kongr45gpen/puzzle-pcb/sciencefestivalpcb/sciencefestivalpcb.kicad_pcb

## KiCad design sciencefestivalpcb/sciencefestivalpcb.kicad_pcb (2023-10-26)

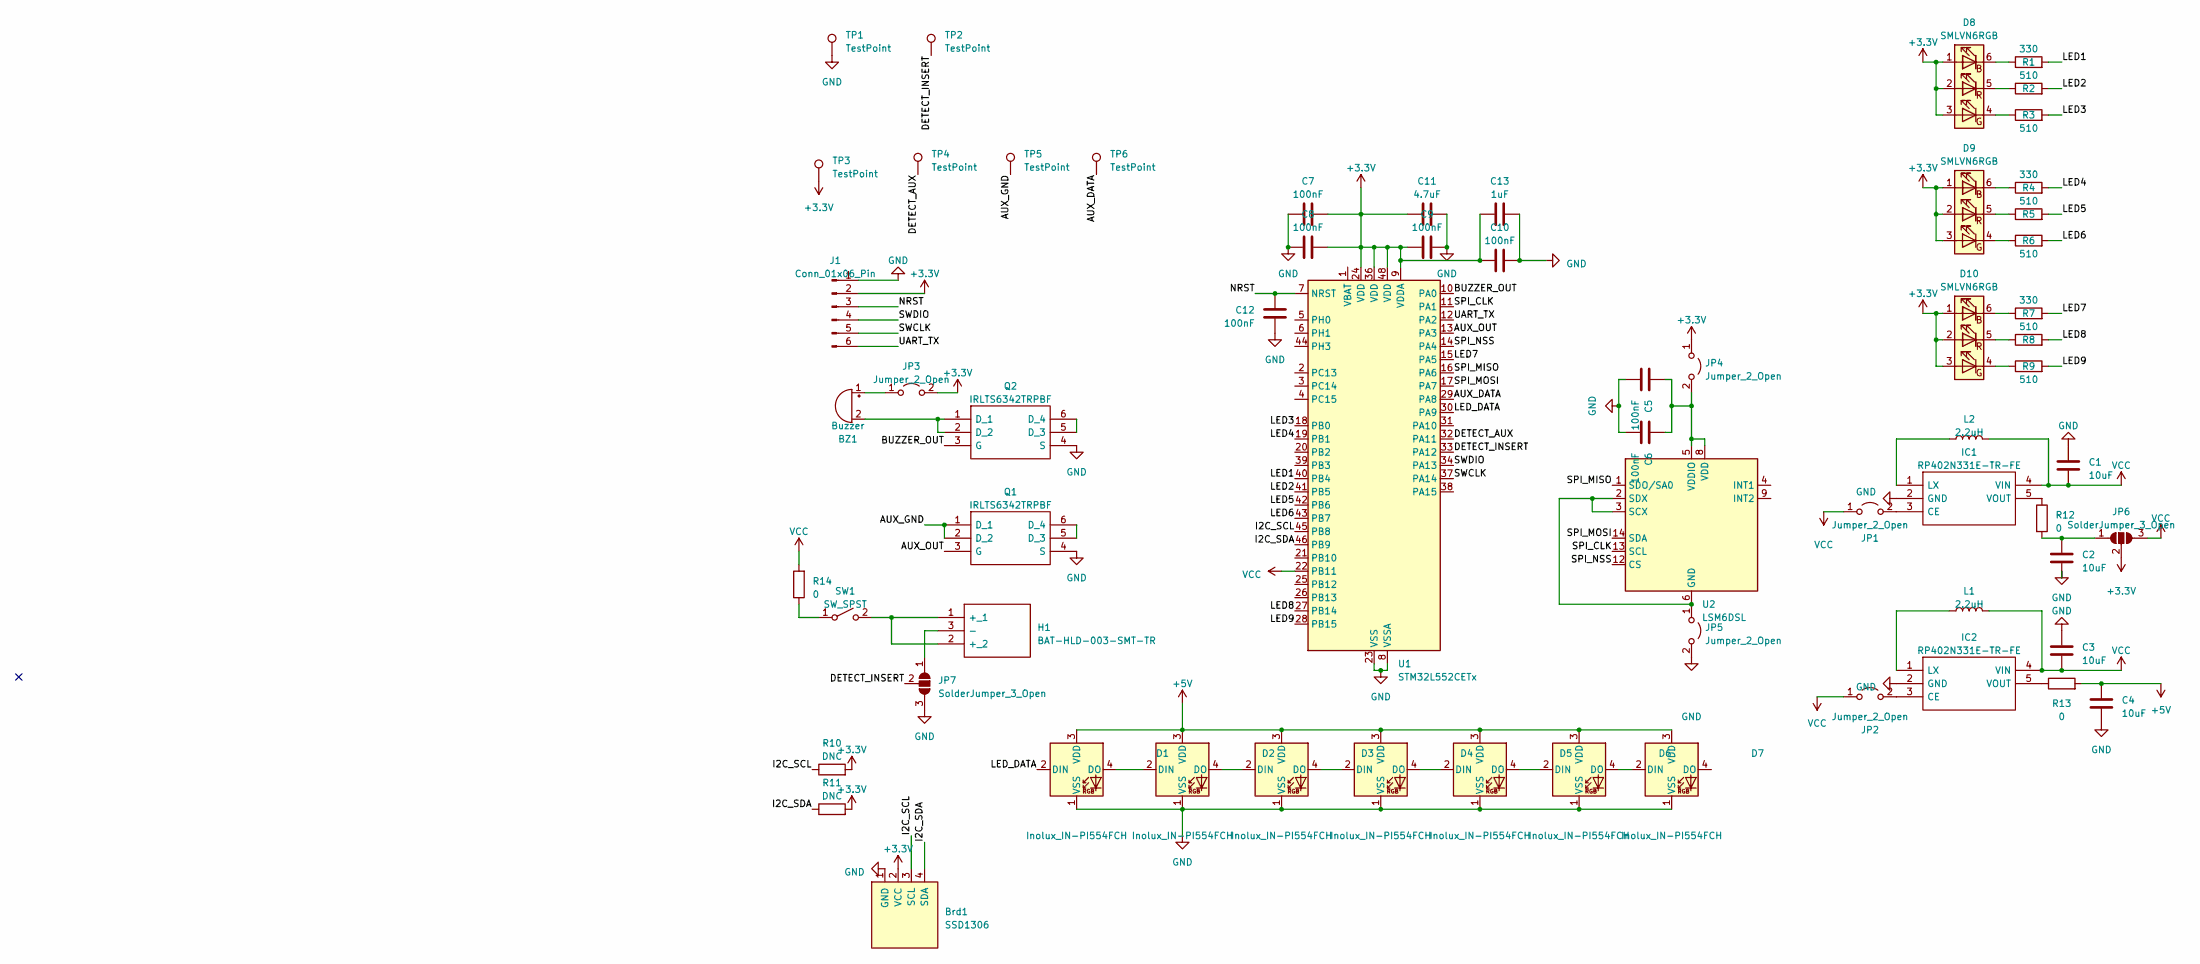
[picture p1: schematic sciencefestivalpcb.kicad_sch]

Parts:
BZ1: Buzzer; Buzzer_12x9.5RM7.6; MPN CSQG703BP
Brd1: SSD1306; 128x64OLED
C1, C2, C3, C4: 10uF; C_0603_1608Metric_Pad1.08x0.95mm_HandSolder; MPN 06033D106KAT2A
C5, C6, C7, C8, C9, C10, C12: 100nF; C_0603_1608Metric_Pad1.08x0.95mm_HandSolder; MPN GRJ188R72A104KE11D
C11: 4.7uF; C_0603_1608Metric_Pad1.08x0.95mm_HandSolder; MPN GRM188R6YA475KE15D
C13: 1uF; C_0603_1608Metric_Pad1.08x0.95mm_HandSolder; MPN 06033W105KAT2A
D1, D2, D3, D4, D5, D6, D7: Inolux_IN-PI554FCH; LED_Inolux_IN-PI554FCH_PLCC4_5.0x5.0mm_P3.2mm; MPN IN-PI554FCH
D8, D9, D10: SMLVN6RGB; LED_ROHM_SMLVN6; MPN SMLVN6RGB1U1
H1: BAT-HLD-003-SMT-TR; BATHLD003SMTTR; Manufacturer_Part_Number BAT-HLD-003-SMT-TR
IC1, IC2: RP402N331E-TR-FE; SOT95P280X130-5N; Mouser Part Number 848-RP402N331ETRFE
J1: Conn_01x06_Pin; Molex_PicoBlade_53261-0671_1x06-1MP_P1.25mm_Horizontal; MPN 53261-0671
JP1, JP2, JP3, JP4, JP5: Jumper_2_Open; SolderJumper-2_P1.3mm_Open_TrianglePad1.0x1.5mm
JP6, JP7: SolderJumper_3_Open; SolderJumper-3_P1.3mm_Open_RoundedPad1.0x1.5mm
L1, L2: 2.2uH; L_0805_2012Metric_Pad1.05x1.20mm_HandSolder; MPN IHHP0805ZHER2R2M01
Q1, Q2: IRLTS6342TRPBF; SOT95P280X145-6N; Mouser Part Number 942-IRLTS6342TRPBF
R1, R4, R7: 330; R_0603_1608Metric_Pad0.98x0.95mm_HandSolder; MPN ERJ-UP3J331V
R2, R3, R5, R6, R8, R9: 510; R_0603_1608Metric_Pad0.98x0.95mm_HandSolder; MPN ERJ-UP3F5100V
R10, R11: DNC; R_0603_1608Metric_Pad0.98x0.95mm_HandSolder
R12, R13, R14: 0; R_0603_1608Metric_Pad0.98x0.95mm_HandSolder; MPN ERJ-3GEY0R00V
SW1: SW_SPST; SW_DIP_SPSTx01_Slide_Omron_A6S-110x_W8.9mm_P2.54mm; MPN A6S-1102-PH
TP1, TP2, TP3, TP4, TP5, TP6: TestPoint; TestPoint_Pad_D4.0mm
U1: STM32L552CETx; LQFP-48_7x7mm_P0.5mm; MPN STM32L552CET6
U2: LSM6DSL; LGA-14_3x2.5mm_P0.5mm_LayoutBorder3x4y; MPN LSM6DSLTR

Connections:
+3.3V: Brd1.2 (VCC), C7.2, C8.2, C9.1, C10.1, C11.1, C13.1, D8.1 (BA), D8.2 (RA), D8.3 (GA), D9.1 (BA), D9.2 (RA), D9.3 (GA), D10.1 (BA), D10.2 (RA), D10.3 (GA), J1.2, JP3.2 (B), JP4.1 (A), JP6.2 (C), R10.2, R11.2, TP3.1, U1.9 (VDDA), U1.24 (VDD), U1.36 (VDD), U1.48 (VDD)
+5V: C4.1, D1.3 (VDD), D2.3 (VDD), D3.3 (VDD), D4.3 (VDD), D5.3 (VDD), D6.3 (VDD), D7.3 (VDD), R13.2
/AUX_DATA: TP6.1, U1.29 (PA8)
/AUX_GND: Q1.1 (D_1), Q1.2 (D_2), TP5.1
/AUX_OUT: Q1.3 (G), U1.13 (PA3)
/BUZZER_OUT: Q2.3 (G), U1.10 (PA0)
/DETECT_AUX: TP4.1, U1.32 (PA11)
/DETECT_INSERT: JP7.2 (C), TP2.1, U1.33 (PA12)
/I2C_SCL: Brd1.3 (SCL), R10.1, U1.45 (PB8)
/I2C_SDA: Brd1.4 (SDA), R11.1, U1.46 (PB9)
/LED1: R1.2, U1.40 (PB4)
/LED2: R2.2, U1.41 (PB5)
/LED3: R3.2, U1.18 (PB0)
/LED4: R4.2, U1.19 (PB1)
/LED5: R5.2, U1.42 (PB6)
/LED6: R6.2, U1.43 (PB7)
/LED7: R7.2, U1.15 (PA5)
/LED8: R8.2, U1.27 (PB14)
/LED9: R9.2, U1.28 (PB15)
/LED_DATA: D1.2 (DIN), U1.30 (PA9)
/NRST: C12.2, J1.3, U1.7 (NRST)
/SPI_CLK: U1.11 (PA1), U2.13 (SCL)
/SPI_MISO: U1.16 (PA6), U2.1 (SDO/SA0)
/SPI_MOSI: U1.17 (PA7), U2.14 (SDA)
/SPI_NSS: U1.14 (PA4), U2.12 (CS)
/SWCLK: J1.5, U1.37 (PA14)
/SWDIO: J1.4, U1.34 (PA13)
/UART_TX: J1.6, U1.12 (PA2)
GND: Brd1.1 (GND), C1.1, C2.2, C3.1, C4.2, C5.2, C6.2, C7.1, C8.1, C9.2, C10.2, C11.2, C12.1, C13.2, D1.1 (VSS), D2.1 (VSS), D3.1 (VSS), D4.1 (VSS), D5.1 (VSS), D6.1 (VSS), D7.1 (VSS), IC1.2 (GND), IC2.2 (GND), J1.1, JP5.2 (B), JP7.3 (B), Q1.4 (S), Q2.4 (S), TP1.1, U1.8 (VSSA), U1.23 (VSS), U1.35 (VSS), U1.47 (VSS)
unnamed: BZ1.2 (+), Q2.1 (D_1), Q2.2 (D_2)
unnamed: BZ1.1 (-), JP3.1 (A)
unnamed: D1.4 (DO), D2.2 (DIN)
unnamed: D2.4 (DO), D3.2 (DIN)
unnamed: D3.4 (DO), D4.2 (DIN)
unnamed: D4.4 (DO), D5.2 (DIN)
unnamed: D5.4 (DO), D6.2 (DIN)
unnamed: D6.4 (DO), D7.2 (DIN)
unnamed: D8.6 (BK), R1.1
unnamed: D8.4 (GK), R3.1
unnamed: D8.5 (RK), R2.1
unnamed: D9.6 (BK), R4.1
unnamed: D9.4 (GK), R6.1
unnamed: D9.5 (RK), R5.1
unnamed: D10.6 (BK), R7.1
unnamed: D10.4 (GK), R9.1
unnamed: D10.5 (RK), R8.1
unnamed: H1.1 (+_1), H1.2 (+_2), SW1.2 (B)
unnamed: H1.3 (-), JP7.1 (A)
unnamed: IC1.3 (CE), JP1.2 (B)
unnamed: IC1.1 (LX), L2.1
unnamed: IC1.5 (VOUT), R12.1
unnamed: IC2.3 (CE), JP2.2 (B)
unnamed: IC2.1 (LX), L1.1
unnamed: IC2.5 (VOUT), R13.1
unnamed: C5.1, C6.1, JP4.2 (B), U2.5 (VDDIO), U2.8 (VDD)
unnamed: JP5.1 (A), U2.2 (SDX), U2.3 (SCX), U2.6 (GND), U2.7 (GND)
unnamed: C2.1, JP6.1 (A), R12.2
unnamed: Q1.5 (D_3), Q1.6 (D_4)
unnamed: Q2.5 (D_3), Q2.6 (D_4)
unnamed: R14.1, SW1.1 (A)
VCC: C1.2, C3.2, IC1.4 (VIN), IC2.4 (VIN), JP1.1 (A), JP2.1 (A), JP6.3 (B), L1.2, L2.2, R14.2, U1.22 (PB11)

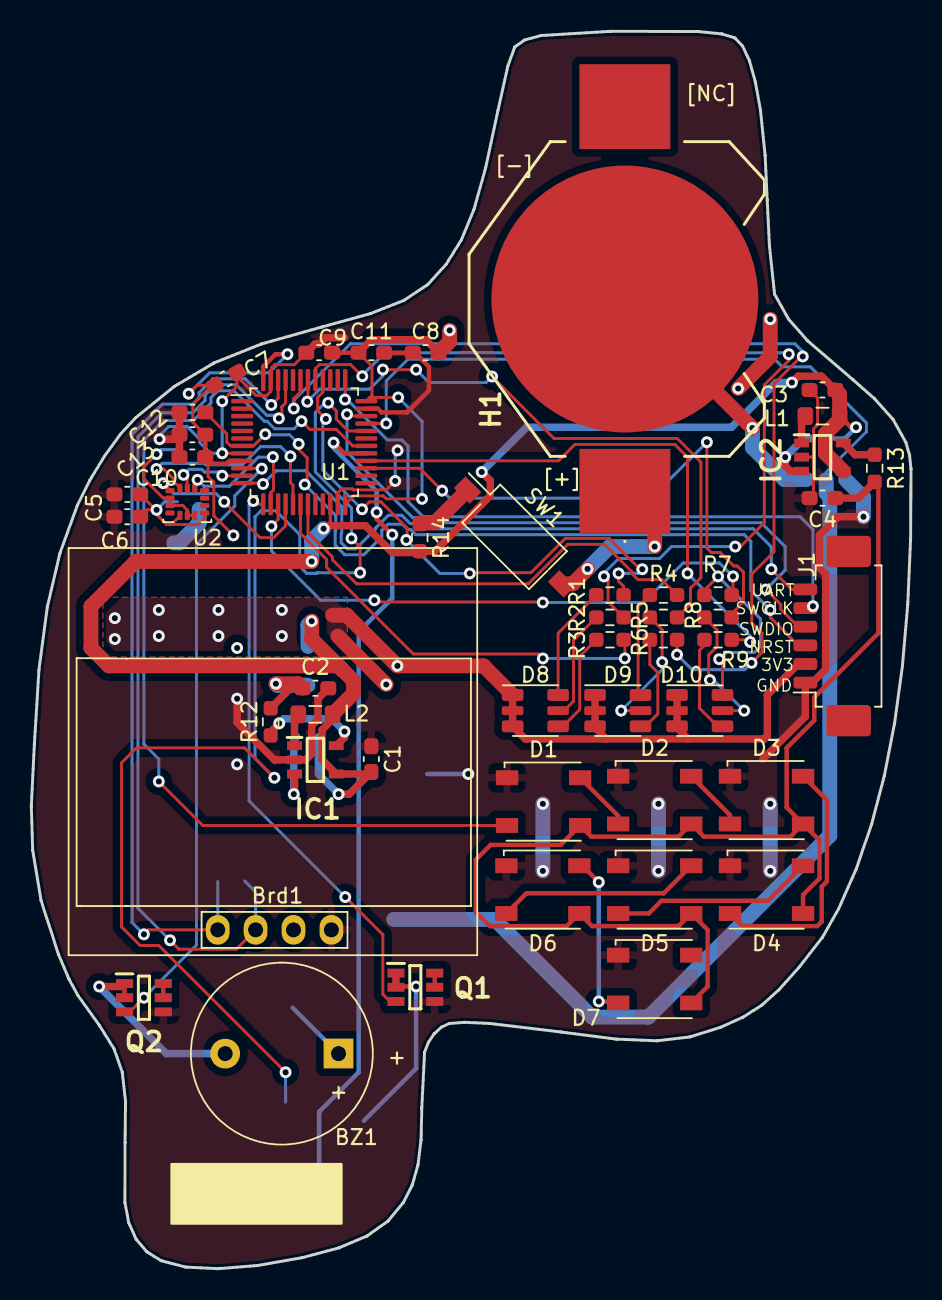
[picture p2: board sciencefestivalpcb.kicad_pcb from above]

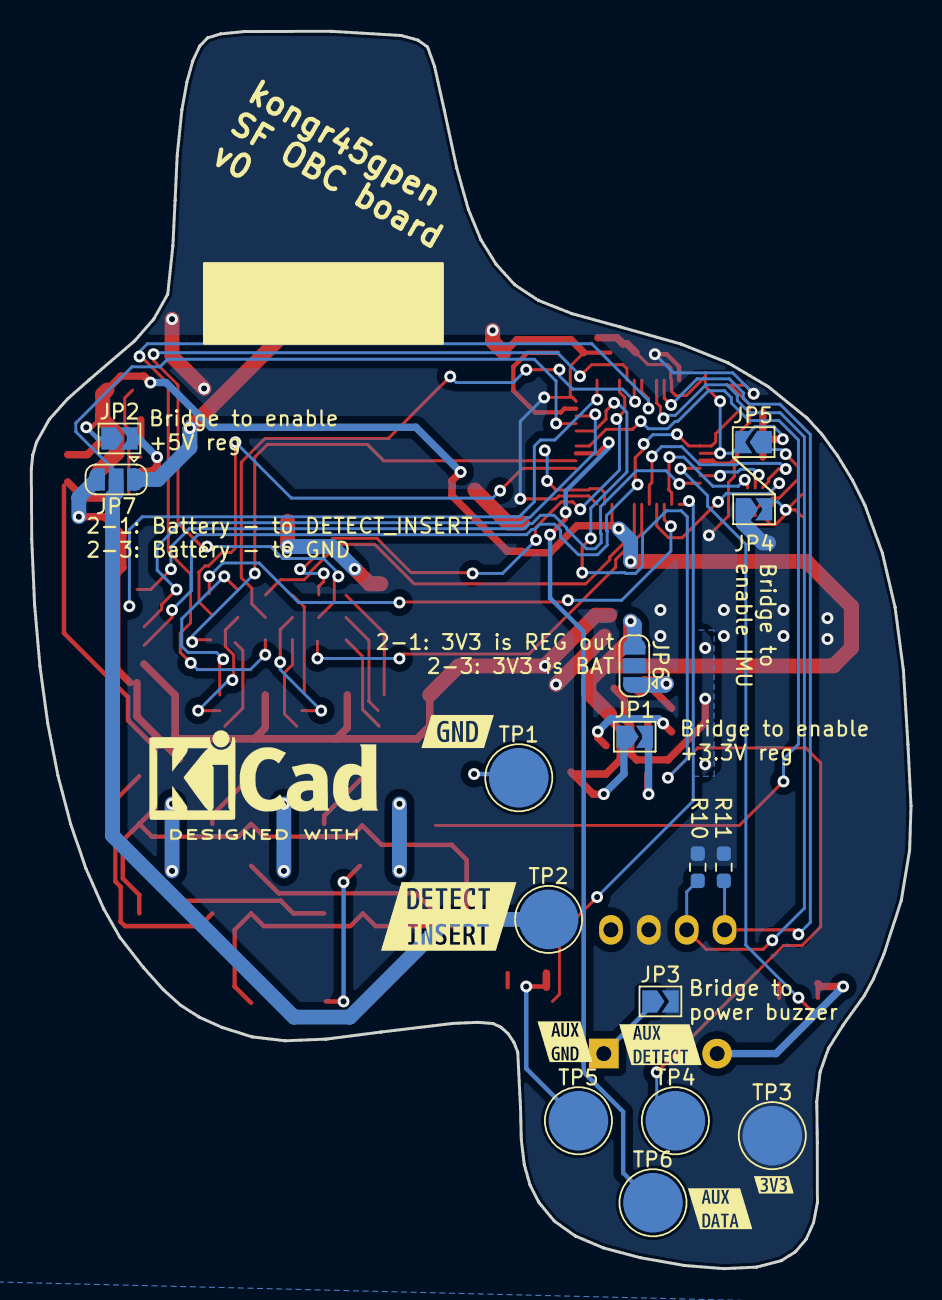
[picture p3: board sciencefestivalpcb.kicad_pcb from below]

Board: 2 copper layers, 59.0 x 83.0 mm, 69 parts (21 on the bottom side), 61 nets.

Other parts of the board:
kibuzzard-65245FE4: G***; kibuzzard-65245FE4
kibuzzard-652460C9: G***; kibuzzard-652460C9
kibuzzard-652460E7: G***; kibuzzard-652460E7
kibuzzard-652460F2: G***; kibuzzard-652460F2
kibuzzard-652460F9: G***; kibuzzard-652460F9
kibuzzard-65246046: G***; kibuzzard-65246046
