kongr45gpen/puzzle-pcb/firmware/Core/Src/main.c

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
/* Includes ------------------------------------------------------------------*/
#include "main.h"

/* USER CODE BEGIN Includes */
#include "../../Drivers/SSD1306/ssd1306.h"
#include "../../Drivers/SSD1306/ssd1306_tests.h"
#include "images.h"
/* USER CODE END Includes */

/* USER CODE BEGIN PTD */
#include "math.h"
#include "stdbool.h"
/* USER CODE END PTD */

/* USER CODE BEGIN PD */
const int startSoundDelay = 7;
const int stopSoundDelay = 15;
const int sleepDelay = 100;
/* USER CODE END PD */

I2C_HandleTypeDef hi2c1;

TIM_HandleTypeDef htim2;
TIM_HandleTypeDef htim3;
TIM_HandleTypeDef htim4;
TIM_HandleTypeDef htim5;
TIM_HandleTypeDef htim15;

UART_HandleTypeDef huart2;

void SystemClock_Config(void);
static void MX_GPIO_Init(void);
static void MX_I2C1_Init(void);
static void MX_USART2_UART_Init(void);
static void MX_ICACHE_Init(void);
static void MX_TIM2_Init(void);
static void MX_TIM3_Init(void);
static void MX_TIM4_Init(void);
static void MX_TIM5_Init(void);
static void MX_TIM15_Init(void);
/**
  * @brief  The application entry point.
  * @retval int
  */
int main(void)
{
  /* MCU Configuration--------------------------------------------------------*/

  /* Reset of all peripherals, Initializes the Flash interface and the Systick. */
  HAL_Init();

  /* Configure the system clock */
  SystemClock_Config();

  /* Initialize all configured peripherals */
  MX_GPIO_Init();
  MX_I2C1_Init();
  MX_USART2_UART_Init();
  MX_ICACHE_Init();
  MX_TIM2_Init();
  MX_TIM3_Init();
  MX_TIM4_Init();
  MX_TIM5_Init();
  MX_TIM15_Init();
  /* USER CODE BEGIN 2 */
  int loops = 0;
  uint32_t lastTime = 0;
  enum Status {
      ERREUR,
      ROCKET
  };
    enum Status status = ERREUR;

    enum PCBStatus {
        PLUGGED,
        UNPLUGGED
    };
    enum PCBStatus oldStatus = PLUGGED;
    enum PCBStatus pcbStatus = UNPLUGGED;

    bool screenConnected = false;
    bool mustUpdateScreen = false;
    bool debouncedStart = true;
  /* USER CODE END 2 */

  /* Infinite loop */
  /* USER CODE BEGIN WHILE */
  while (1)
  {
    /* USER CODE END WHILE */

    /* USER CODE BEGIN 3 */

    HAL_TIM_Base_Start(&htim2);
    HAL_TIM_Base_Start(&htim3);
    HAL_TIM_Base_Start(&htim4);
    HAL_TIM_Base_Start(&htim5);
    HAL_TIM_Base_Start(&htim15);

    HAL_TIM_PWM_Start(&htim2, TIM_CHANNEL_1);
    HAL_TIM_PWM_Start(&htim3, TIM_CHANNEL_1);
    HAL_TIM_PWM_Start(&htim3, TIM_CHANNEL_2);
    HAL_TIM_PWM_Start(&htim3, TIM_CHANNEL_3);
    HAL_TIM_PWM_Start(&htim3, TIM_CHANNEL_4);
    HAL_TIM_PWM_Start(&htim4, TIM_CHANNEL_1);
    HAL_TIM_PWM_Start(&htim4, TIM_CHANNEL_2);
    HAL_TIM_PWM_Start(&htim15, TIM_CHANNEL_1);
    HAL_TIM_PWM_Start(&htim15, TIM_CHANNEL_2);

    if (!HAL_GPIO_ReadPin(DETECT_INSERT_GPIO_Port, DETECT_INSERT_Pin)) {
        pcbStatus = PLUGGED;
    } else {
        pcbStatus = UNPLUGGED;
    }

    if (is_screen_connected()) {
        if (!screenConnected) {
            ssd1306_Init();
            ssd1306_Fill(Black);
            ssd1306_UpdateScreen();
            mustUpdateScreen = true;
        }
        screenConnected = true;
    } else {
        screenConnected = false;
    }

    if (oldStatus != pcbStatus && pcbStatus == UNPLUGGED) {
        //debounce
        HAL_Delay(100);
        if (!HAL_GPIO_ReadPin(DETECT_INSERT_GPIO_Port, DETECT_INSERT_Pin)) {
            // Plugged
            continue;
        }
    }

    // PCB status changed!
    if (oldStatus != pcbStatus) {
        oldStatus = pcbStatus;
        loops = 0;
        lastTime = HAL_GetTick();

        // Turn off all leds
        leds_off();

        // Clear screen
        ssd1306_Fill(Black);
        ssd1306_UpdateScreen();

        // Stop any sound
        stop_sound();
    }

    if (pcbStatus == PLUGGED) {
        if (loops < startSoundDelay) {
            set_led(LED1B, 50);
            set_led(LED2B, 100);
            set_led(LED3B, 200);
            // DEBOUNCING
            HAL_Delay(100);
            loops++;
            debouncedStart = false;
            continue;
        } else {
            set_led(LED1B, 0);
            set_led(LED2B, 0);
            set_led(LED3B, 0);
            debouncedStart = true;
        }

        if (loops == startSoundDelay + 3) {
            start_sound(400 * powf(2, 7.0f / 12.0f));
        } else if (loops == startSoundDelay + 6) {
            stop_sound();
        } else if (loops == startSoundDelay + 9) {
            start_sound(400 * powf(2, 7.0f / 12.0f));
        } else if (loops >= startSoundDelay + 12) {
            stop_sound();
        }

        if (loops % 3 == 0) {
            static int the_led = 0;
            the_led = (the_led + 1) % 3;

            set_led(LED1G, the_led == 0 ? 1000 : 0);
            set_led(LED2G, the_led == 1 ? 1000 : 0);
            set_led(LED3G, the_led == 2 ? 1000 : 0);
        }

        int64_t pseudorandom1 = (int64_t) ((double)loops * (double)loops * 164641.73f);
        int64_t pseudorandom2 = (int64_t) ((double)loops * (double)loops * 3046751.73f);

        ssd1306_Fill(Black);
        ssd1306_DrawBitmap(35 - 10 + (pseudorandom1 % 16), pseudorandom2 % 6, rocket_58x58, 58, 58, White);

        ssd1306_UpdateScreen();

        HAL_Delay(20);
    } else { // UNPLUGGED

        float brightness = (1 - (float)loops / (float)sleepDelay);
        // gamma correction
        brightness = powf(brightness, 2.f);
        brightness *= 4095 / 3;

        if (loops >= sleepDelay || !debouncedStart) {
            stop_everything();
            // Disable systick so that it doesn't wake up the processor every ms and doesn't keep counting.
            // Hopefully will prevent some battery drain.
            HAL_NVIC_DisableIRQ(SysTick_IRQn);
            sleep();
            HAL_NVIC_EnableIRQ(SysTick_IRQn);
            continue;
        }

        if (loops == stopSoundDelay + 3) {
            start_sound(400);
        } else if (loops == stopSoundDelay + 12) {
            stop_sound();
        } else if (loops == stopSoundDelay + 20) {
            start_sound(400 * powf(2, 3.0f / 12.0f));
        } else if (loops == stopSoundDelay + 30) {
            start_sound(400 * powf(2, -3.0f / 12.0f));
        } else if (loops >= stopSoundDelay + 40) {
            stop_sound();
        }

        if (loops <= 1 || mustUpdateScreen) {
            ssd1306_SetCursor(30, 46);
            ssd1306_WriteString("ERROR", Font_11x18, White);
            ssd1306_DrawBitmap(40, 0, warning_48x48, 48, 48, White);

            ssd1306_UpdateScreen();

            mustUpdateScreen = false;
        }

        if (loops % 4 == 0) {
            set_led(LED1R, 0);
            set_led(LED2R, 0);
        } else if (loops % 2 == 0) {
            set_led(LED1R, brightness);
            set_led(LED2R, brightness);
        }
        HAL_Delay(20);
    }

//    if (HAL_GPIO_ReadPin(DETECT_INSERT_GPIO_Port, DETECT_INSERT_Pin)) {
//
//    }

//    if (HAL_GPIO_ReadPin(DETECT_INSERT_GPIO_Port, DETECT_INSERT_Pin)) {
//        HAL_GPIO_WritePin(LED3_GPIO_Port, LED3_Pin, GPIO_PIN_SET);
//        HAL_GPIO_WritePin(LED6_GPIO_Port, LED6_Pin, GPIO_PIN_SET);
//        HAL_GPIO_WritePin(LED5_GPIO_Port, LED2_Pin, GPIO_PIN_SET);
//        HAL_GPIO_WritePin(LED5_GPIO_Port, LED5_Pin, GPIO_PIN_SET);
//
//        HAL_GPIO_TogglePin(LED2_GPIO_Port, LED2_Pin);
//        HAL_Delay(30);
//        HAL_GPIO_TogglePin(LED5_GPIO_Port, LED5_Pin);
//        HAL_Delay(200);
//
//        HAL_GPIO_TogglePin(LED2_GPIO_Port, LED2_Pin);
//        HAL_GPIO_TogglePin(LED5_GPIO_Port, LED5_Pin);
//        HAL_Delay(200);
//    } else {
//        status = ERREUR;
//
//        if (loops % 3 == 0) {
//            HAL_GPIO_TogglePin(LED3_GPIO_Port, LED3_Pin);
//            HAL_GPIO_TogglePin(LED6_GPIO_Port, LED6_Pin);
//        }
//        HAL_Delay(20);
//    } //else if (loops == 5) {
//        // Turn them off
//        HAL_GPIO_WritePin(LED2_GPIO_Port, LED2_Pin, GPIO_PIN_SET);
//        HAL_GPIO_WritePin(LED5_GPIO_Port, LED5_Pin, GPIO_PIN_SET);
//
//        // Open green ones
//        HAL_GPIO_WritePin(LED3_GPIO_Port, LED3_Pin, GPIO_PIN_RESET);
//
//        status = ROCKET;
//    } else {
//        if (loops % 3 == 0) {
//            HAL_GPIO_TogglePin(LED3_GPIO_Port, LED3_Pin);
//            HAL_GPIO_TogglePin(LED6_GPIO_Port, LED6_Pin);
//        }
//        HAL_Delay(20);
//    }
//
//    if (loops % 4 == 0 && status == ERREUR) {
//        ssd1306_Init();
//    }
//
//    if (status == ERREUR && loops % 4 == 0) {
//        ssd1306_SetCursor(30, 46);
//        ssd1306_WriteString("ERROR", Font_11x18, White);
//        ssd1306_DrawBitmap(40, 0, warning_48x48, 48, 48, White);
//
//        ssd1306_UpdateScreen();
//    } else if (status == ROCKET) {
//        int64_t pseudorandom1 = (int64_t) ((double)loops * (double)loops * 164641.73f);
//        int64_t pseudorandom2 = (int64_t) ((double)loops * (double)loops * 3046751.73f);
//
//        ssd1306_Fill(Black);
//        ssd1306_DrawBitmap(35 - 10 + (pseudorandom1 % 16), pseudorandom2 % 6, rocket_58x58, 58, 58, White);
//
//        ssd1306_UpdateScreen();
//    }

    loops++;
  }
  /* USER CODE END 3 */
}

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
