kongr45gpen/puzzle-pcb/firmware/firmware.ioc

Mcu.UserName=STM32L552CETx
PA0.GPIO_Label=BUZZER_OUT
PA0.Signal=S_TIM5_CH1
PA12.GPIO_Label=DETECT_INSERT
PA12.Signal=GPXTI12
PA2.Signal=USART2_TX
PA5.Signal=S_TIM2_CH1
PB0.Signal=S_TIM3_CH3
PB1.Signal=S_TIM3_CH4
PB14.Signal=S_TIM15_CH1
PB15.Signal=S_TIM15_CH2
PB5.Signal=S_TIM3_CH2
PB6.Signal=S_TIM4_CH1
PB7.Signal=S_TIM4_CH2
PB8.Signal=I2C1_SCL
PB9.Signal=I2C1_SDA
