kongr45gpen/puzzle-pcb/firmware/Core/Inc/main.h

#define BUZZER_OUT_Pin GPIO_PIN_0
#define BUZZER_OUT_GPIO_Port GPIOA
#define DETECT_INSERT_Pin GPIO_PIN_12
#define DETECT_INSERT_GPIO_Port GPIOA
#define DETECT_INSERT_EXTI_IRQn EXTI12_IRQn
