kongr45gpen/puzzle-pcb/(commit log)

2023-10-26 Initial firmware commit
    [sciencefestivalpcb.kicad_pcb, sciencefestivalpcb.kicad_sch, st_nucleo_l5.cfg]
2023-10-26 Add SSD1306 drivers
2023-11-07 Put all LEDs on timers
